drunkbatya/DrunkPC/arduino-128x64/README.md

## Description
It's an Arduino sketch, to test Samsung KS0108-based 128x64 dot LCD without any library.

## Shematic
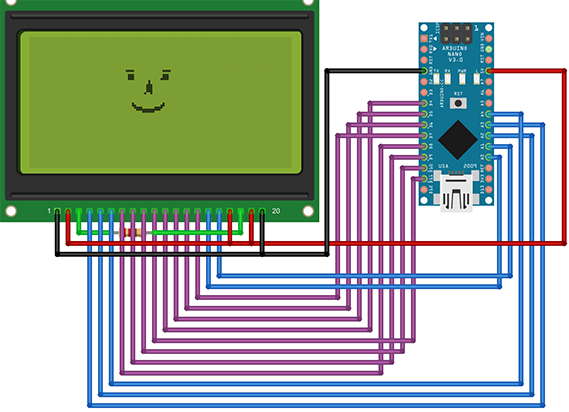
[picture p2: assets/img/128x64_arduino-v0.1.png]
shematic


## Usage
U may send chars to display via UART like:
```bash
minicom -D /dev/cu.usbserial-14220 -b 115200
```
