drunkbatya/DrunkPC/hardware/BOM_DrunkPCZ80v3Public_2025-09-06.csv

ID | Name | Designator | Footprint | Quantity | Manufacturer Part | Manufacturer | Supplier | Supplier Part | Price
1 | 100nF | C3,C9,C2,C1,C5,C4,C6,C7 | C1206 | 8 | CL31B104KBCNNNC | SAMSUNG(三星) | LCSC | C24497 | 0.014
2 | 160Ω | R14 | R2512 | 1 | AC2512FK-07160RL | YAGEO(国巨) | LCSC | C728119 | 0.047
3 | 1kΩ | R10,R5,R6,R7,R8,R9,R17 | R1206 | 7 | 1206W4F1001T5E | UNI-ROYAL(厚声) | LCSC | C4410 | 0.003
4 | IP5306 | U7 | ESOP-8_L4.9-W3.9-P1.27-LS6.0-BL-EP | 1 | IP5306 | INJOINIC(英集芯) | LCSC | C181692 | 0.27
5 | CHF-R3C1LBM15MN2 | CARD1 | CF-SMD_CHF-R3C1LBM15MN2 | 1 | CFH-R3C1LBM15MN2 | UMaxconn(友贸) | LCSC | C404105 | 1.72
6 | 5.1kΩ | R12,R13 | R1206 | 2 | RC1206FR-075K1L | YAGEO(国巨) | LCSC | C163372 | 0.004
7 | 1uH | L1 | IND-SMD_L7.1-W6.6 | 1 | MDA7030-1R0M | KOHERelec(科或) | LCSC | C2847480 | 0.575
8 | 10kΩ | R11 | R1206 | 1 | 1206W4F1002T5E | UNI-ROYAL(厚声) | LCSC | C17902 | 0.003
9 | 10uF | C10,C11 | C1206 | 2 | CL31A106KBHNNNE | SAMSUNG(三星) | LCSC | C13585 | 0.034
10 | 22uF | C12,C14,C15,C16,C17,C13 | C1206 | 6 | CL31A226KOHNNNE | SAMSUNG(三星) | LCSC | C90146 | 0.035
11 | 2Ω | R15 | R1206 | 1 | 1206W4F200KT5E | UNI-ROYAL(厚声) | LCSC | C17942 | 0.005
12 | 500mΩ | R16 | R0805 | 1 | 0805W8F500LT5E | UNI-ROYAL(厚声) | LCSC | C28319 | 0.004
13 | 10kΩ | VR1 | RES-ADJ-TH_3362P | 1 | 3362P-1-103LF | BOURNS | LCSC | C58159 | 0.346
14 | XL-3216SURC | LED1,LED2 | LED1206-R-RD_RED | 2 | XL-3216SURC | XINGLIGHT(成兴光) | LCSC | C965822 | 0.009
15 | TS-KG02S | SW62,SW2,SW3,SW4,SW5,SW6,SW7,SW8,SW9,SW10,SW11,SW12,SW13,SW14,SW15,SW16,SW17,SW18,SW19,SW20,SW21,SW22,SW23,SW24,SW25,SW26,SW27,SW28,SW29,SW30,SW31,SW32,SW33,SW34,SW35,SW36,SW37,SW38,SW39,SW40,SW41,SW42,SW43,SW44,SW45,SW46,SW47,SW48,SW49,SW50,SW51,SW52,SW53,SW54,SW55,SW56,SW57,SW58,SW59,SW60,SW61 | SW-SMD_4P-L6.0-W6.0-P3.90-LS9.5 | 61 | TS-KG02S | HANBO(汉博) | LCSC | C410366 | 0.038
16 | 4MHz | U11 | OSC-TH_4P-L12.7-W12.7-P7.62-BL | 1 | ACH-20.000MHZ-EK | ABRACON | LCSC | C1669914 | 1.239
17 | 10uF | C8 | CAP-SMD_BD5.0-L5.3-W5.3-LS6.3-FD | 1 | RVT1V100M0505 | ROQANG(容强) | LCSC | C72486 | 0.021
18 | 12kΩ | R4 | R1206 | 1 | RC1206FR-0712KL | YAGEO(国巨) | LCSC | C114930 | 0.004
19 | CAY16-103J4LF | R3,R1,R2 | RES-ARRAY-SMD_0603-8P-L3.2-W1.6-BL | 3 | CAY16-103J4LF | BOURNS | LCSC | C784821 | 0.033
20 | Z80CPU | U1 | Z80DIP_CLEAR | 1
21 | WG24064A | U4 | WG24064 | 1 | WG24064A-YGH-TZK# | Winstar
22 | 1N4148 | D2,D3,D4,D5,D6,D7,D8,D9,D10,D11,D12,D13,D14,D15,D16,D17,D18,D19,D20,D21,D22,D23,D24,D25,D26,D27,D28,D29,D30,D31,D32,D1,D33,D34,D35,D36,D37,D38,D39,D40,D41,D42,D43,D44,D45,D46,D47,D48,D49,D50,D51,D52,D53,D54,D55,D56,D57,D58,D59 | SOD-123_L2.8-W1.8-LS3.7-RD | 59 | 1N4148W | YFW(佑风微) | LCSC | C1884539 | 0.009
23 | TYPE_C_SMD_6P | USB1 | TYPE-C-SMD_TYPE-C-6P | 1 | TYPE_C_SMD_6P | null | LCSC | C9900003080
24 | SN74LS273N | U5 | PDIP-20_L25.4-W6.4-P2.54-LS7.6-BL | 1 | SN74LS273N | TI(德州仪器) | LCSC | C2879026 | 3.011
25 | SN74LS244N | U8 | DIP-20_L25.5-W10.0-P2.54-LS7.6-BL | 1 | SN74LS244N | TI(德州仪器) | LCSC | C352965 | 1.023
26 | SN74LS138N | U9 | DIP-16_L19.8-W6.5-P2.54-LS7.6-BL | 1 | SN74LS138N | TI(德州仪器) | LCSC | C352964 | 0.81
27 | SN74LS32N | U10 | PDIP-14_L19.6-W6.5-P2.54-LS7.9-BL | 1 | SN74LS32N | TI(德州仪器) | LCSC | C273644 | 0.312
28 | AS6C1008-55PCN | U2 | PDIP-32_L42.0-W13.7-P2.54-LS15.6-BL | 1 | AS6C1008-55PCN | Alliance Memory | LCSC | C1523885 | 6.883
29 | AT28C256-15PU | U3 | PDIP-28_L37.0-W13.5-P2.54-LS15.6-BL | 1 | AT28C256-15PU | MICROCHIP(美国微芯) | LCSC | C1348752 | 21.127
30 | X6521FV-2X27-C85D32 | U6 | HDR-TH_54P-P2.54-V-F-R2-C27-S2.54 | 1 | X6521FV-2x27-C85D32 | XKB Connectivity(中国星坤) | LCSC | C2884000 | 0.978
