drunkbatya/DrunkPC/hardware/Schematic_DrunkPCZ80v3Public_2025-09-06.pdf

## Keyboard

## Pull resistors

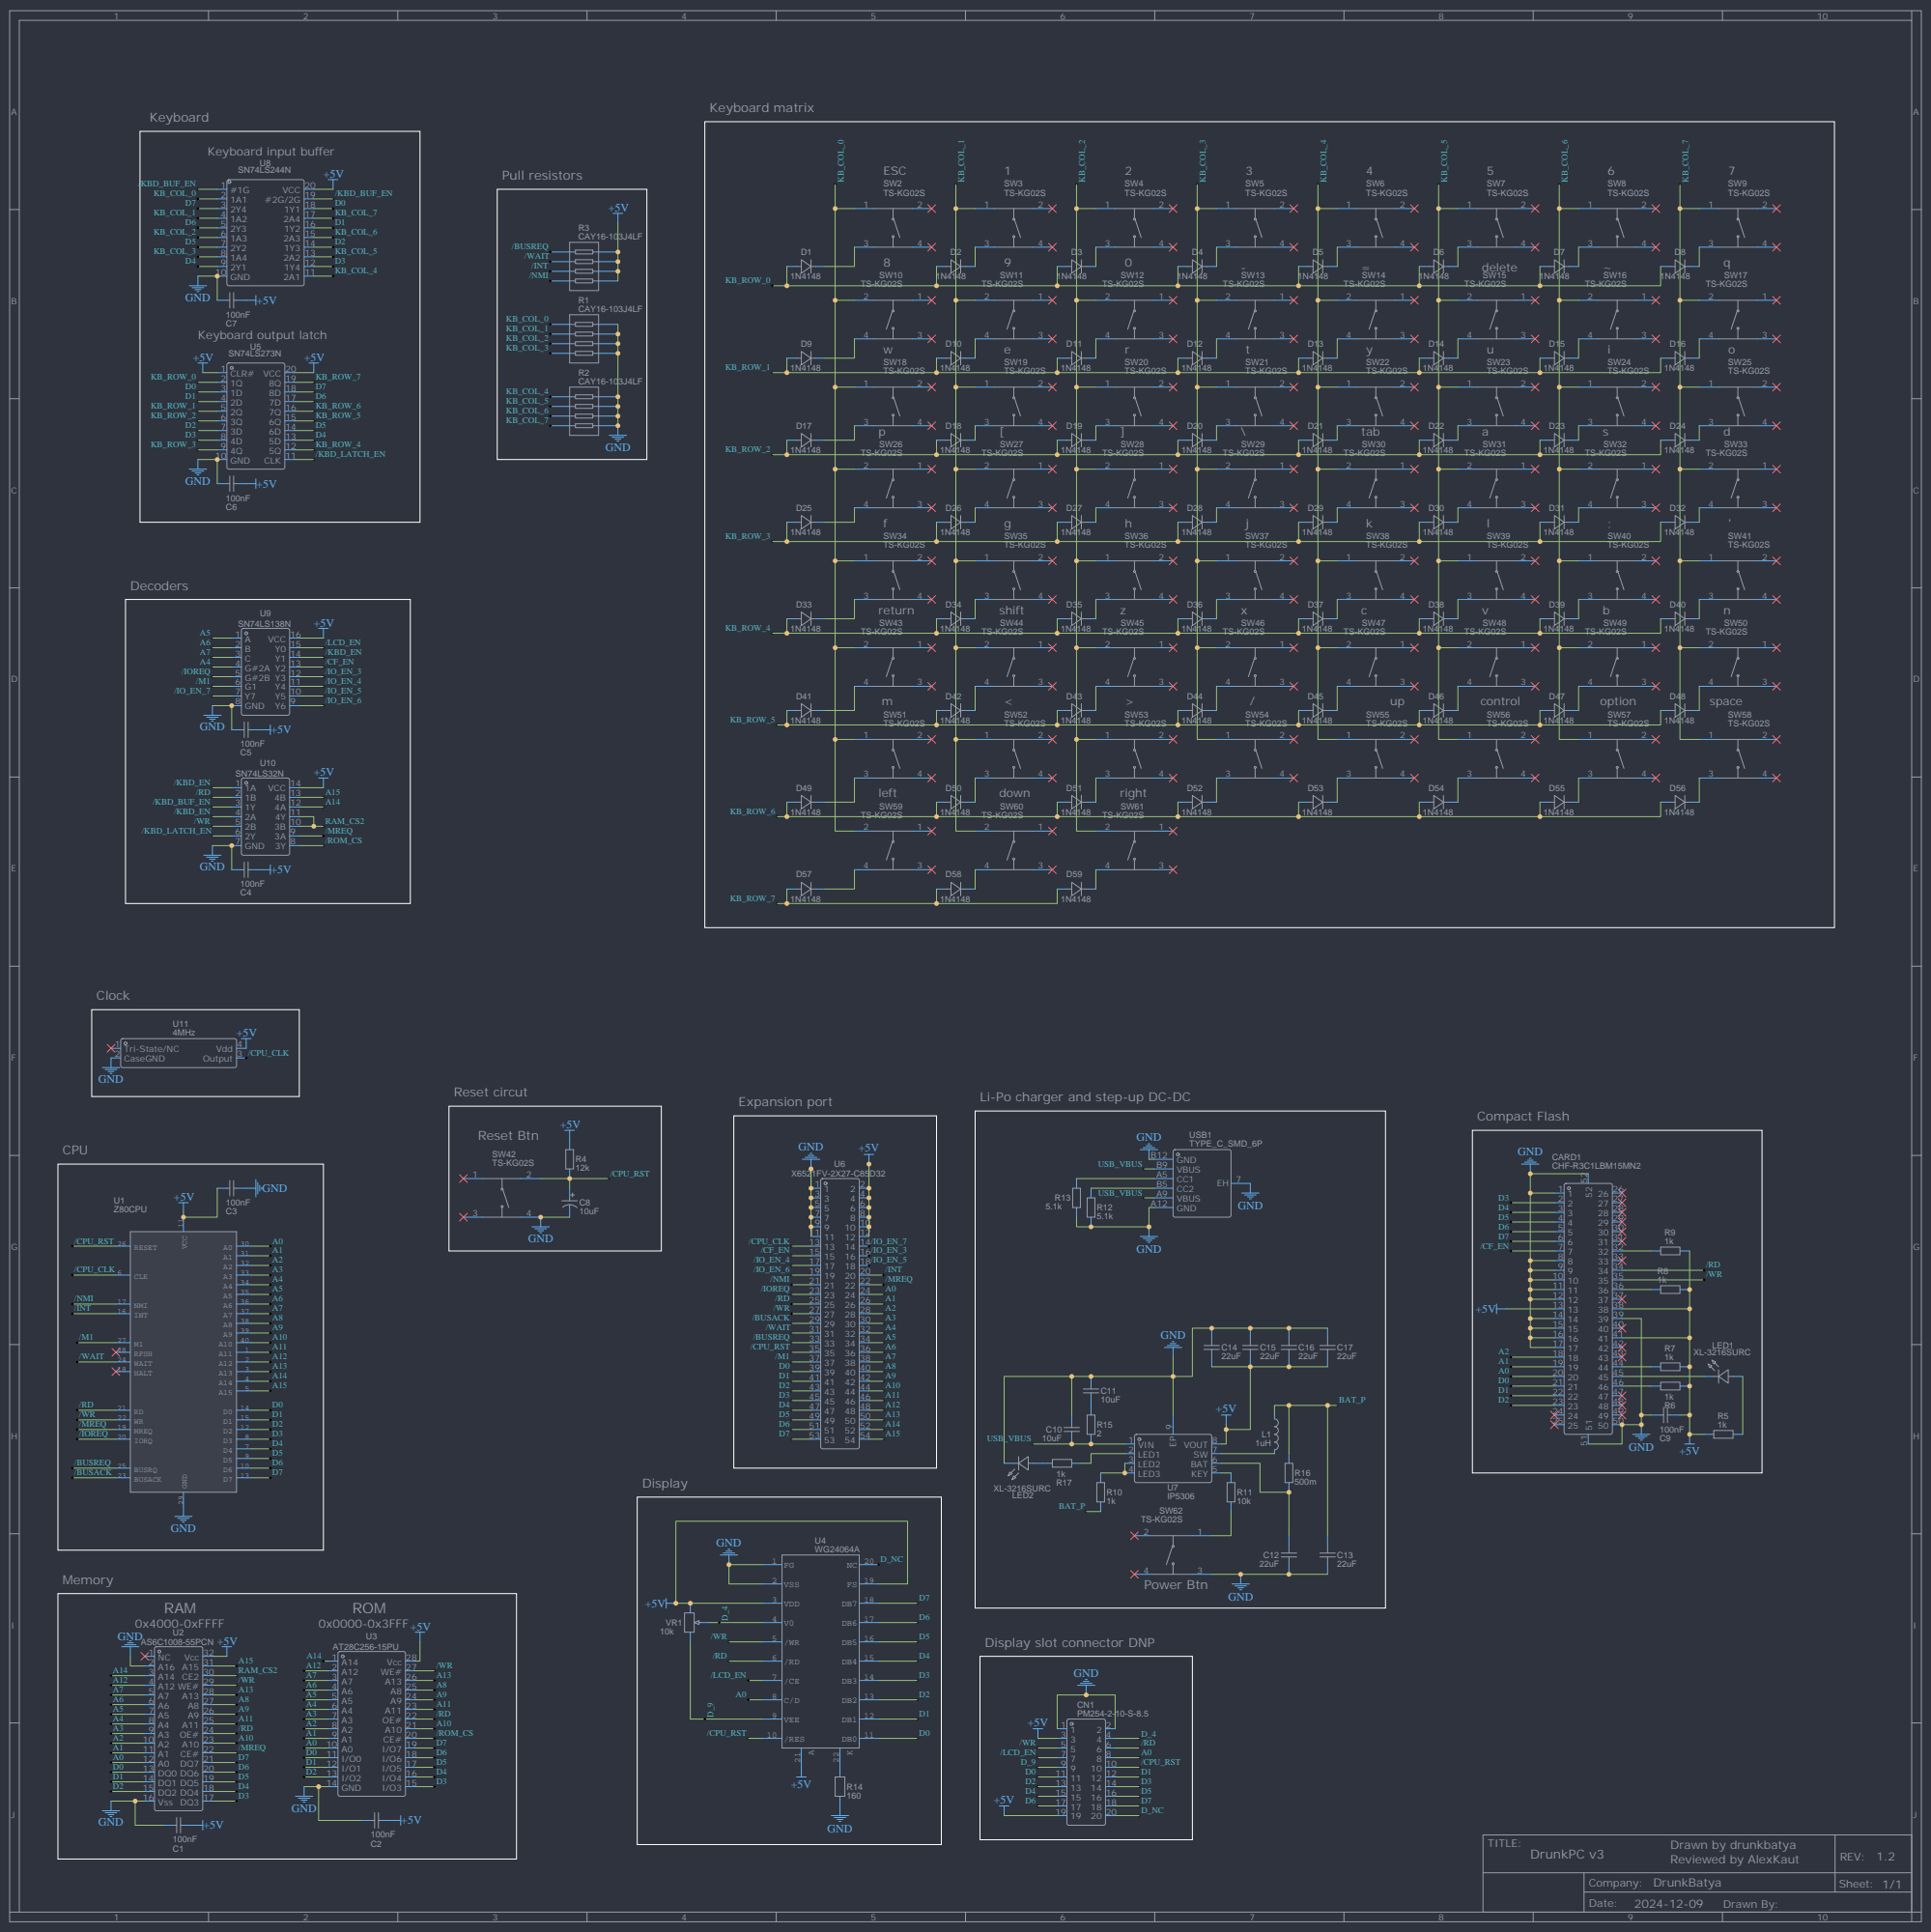
[picture p3: page 1]

Li-Po charger and step-up DC-DC

Display slot connector DNP
