drunkbatya/DrunkPC/devBoard/devBoard-stm32-clock/Core/Src/main.c

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
/* Includes ------------------------------------------------------------------*/
#include "main.h"

/* USER CODE BEGIN Includes */
#include <string.h>
#include "sh1106_buf.h"
#include "menu.h"
#include "encoder.h"
/* USER CODE END Includes */

/* USER CODE BEGIN PD */
#define DISP_CTRL_PORT GPIOB
#define DISP_DC GPIO_PIN_7
#define DISP_RES GPIO_PIN_8
/* USER CODE END PD */

 SPI_HandleTypeDef hspi1;

TIM_HandleTypeDef htim1;

void SystemClock_Config(void);
static void MX_GPIO_Init(void);
static void MX_SPI1_Init(void);
static void MX_TIM1_Init(void);
/**
  * @brief  The application entry point.
  * @retval int
  */
int main(void)
{
  /* MCU Configuration--------------------------------------------------------*/

  /* Reset of all peripherals, Initializes the Flash interface and the Systick. */
  HAL_Init();

  /* Configure the system clock */
  SystemClock_Config();

  /* Initialize all configured peripherals */
  MX_GPIO_Init();
  MX_SPI1_Init();
  MX_TIM1_Init();
  /* USER CODE BEGIN 2 */
    HAL_TIM_Encoder_Start(&htim1, TIM_CHANNEL_ALL);
    encoder_init(TIM1);
    sh1106_init(DISP_CTRL_PORT, &hspi1, DISP_DC, DISP_RES);

    // sh1106_dirty_clear_screen();
    // sh1106_write_str("#!/bin/bash", 40, 2);
  /* USER CODE END 2 */

  /* Infinite loop */
  /* USER CODE BEGIN WHILE */
  while (1)
  {
        t_encoder_move encoder_cur = encoder_move();
        if (encoder_cur == ENCODER_DOWN)
            menu_prev();
        if (encoder_cur == ENCODER_UP)
            menu_next();
        sh1106_clear_screen();
        menu_show_view();
        sh1106_write_buffer();
    /* USER CODE END WHILE */

    /* USER CODE BEGIN 3 */
  }
  /* USER CODE END 3 */
}

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
