drunkbatya/DrunkPC/devBoard/devBoard-stm32-clock/devBoard-stm32-clock.ioc

Mcu.UserName=STM32F401CDUx
PA8.Signal=S_TIM1_CH1
PA9.Signal=S_TIM1_CH2
PB3.Signal=SPI1_SCK
PB5.Signal=SPI1_MOSI
PB6.Signal=GPIO_Output
PB7.Signal=GPIO_Output
PB8.Signal=GPIO_Output
