drunkbatya/DrunkPC/devBoard/devBoard-stm32-clock/Core/Inc/sh1106_buf.h

#ifndef _SH1106_BUF_H_
#define _SH1106_BUF_H_

#define SH1106_WIDTH 128
#define SH1106_HEIGHT 64
#define SH1106_PAGES (SH1106_HEIGHT / 8)

#define SH1106_CMD 0
#define SH1106_DATA 0x01
#define SH1106_CHAR_INV 0
#define SH1106_CHAR_NOINV 0x01

#define SH1106_DISP_OFF 0xAE
#define SH1106_DISP_ON 0xAF
#define SH1106_SET_RAM_PAGE 0xB0
#define SH1106_SET_LOWER_COLUMN_BITS 0x02  // always 2 dot left padding
#define SH1106_SET_HIGHER_COLUMN_BITS 0x10

#define SH1106_CHAR_WIDTH 5
#define SH1106_CHAR_HEIGHT 7

extern uint8_t sh1106_buf[SH1106_WIDTH * SH1106_HEIGHT];

void sh1106_init(GPIO_TypeDef *port, SPI_HandleTypeDef *spi, uint16_t dc_pin, uint16_t res_pin);
void sh1106_write_buffer(void);
void sh1106_write_all_chars(void);
void sh1106_clear_screen(void);
void sh1106_write_str(char *str, uint8_t column, uint8_t page);
void sh1106_write_str_inv(char *str, uint8_t column, uint8_t page);
void sh1106_write_num(int32_t num, uint8_t column, uint8_t page);

#endif  // _SH1106_BUF_H_
