drunkbatya/DrunkPC/(commit log)

2022-07-01 Add test arduino schematic
2022-07-01 Resizing arduino test schematic
2022-07-01 Resizing arduino test schematic again
2022-07-01 Resizing arduino test schematic and again
2022-07-01 editing arduino test image
2022-07-10 starting develop STM32-based dev-board
2022-07-20 Add reading encoder via TIM1
2022-07-22 add basic menu, encoder read file
2024-04-15 Add C compiler glue script
2024-04-21 Add sbrk, remove overclean framebuffer
2024-05-10 Add working debugger UART
2024-11-09 Add cursor move, some fixes
    [main.c]
2024-11-22 Add insert to string
2024-11-22 Add working deleting, inserting chars to user input buffer
2024-12-03 I'm so tired
2025-09-06 Add hardware data, edit README
    [BOM_DrunkPCZ80v3Public_2025-09-06.csv, PickAndPlace_PCB_DrunkPCZ80v3_2025-09-06.csv]
