drunkbatya/DrunkPC/(notices)

Notices in the files:
devBoard/devBoard-stm32-clock/Core/Src/main.c:
Copyright (c) 2022 STMicroelectronics.
All rights reserved.
This software is licensed under terms that can be found in the LICENSE file
